harris887/AGV7/AGV7_DAM0808.jpg

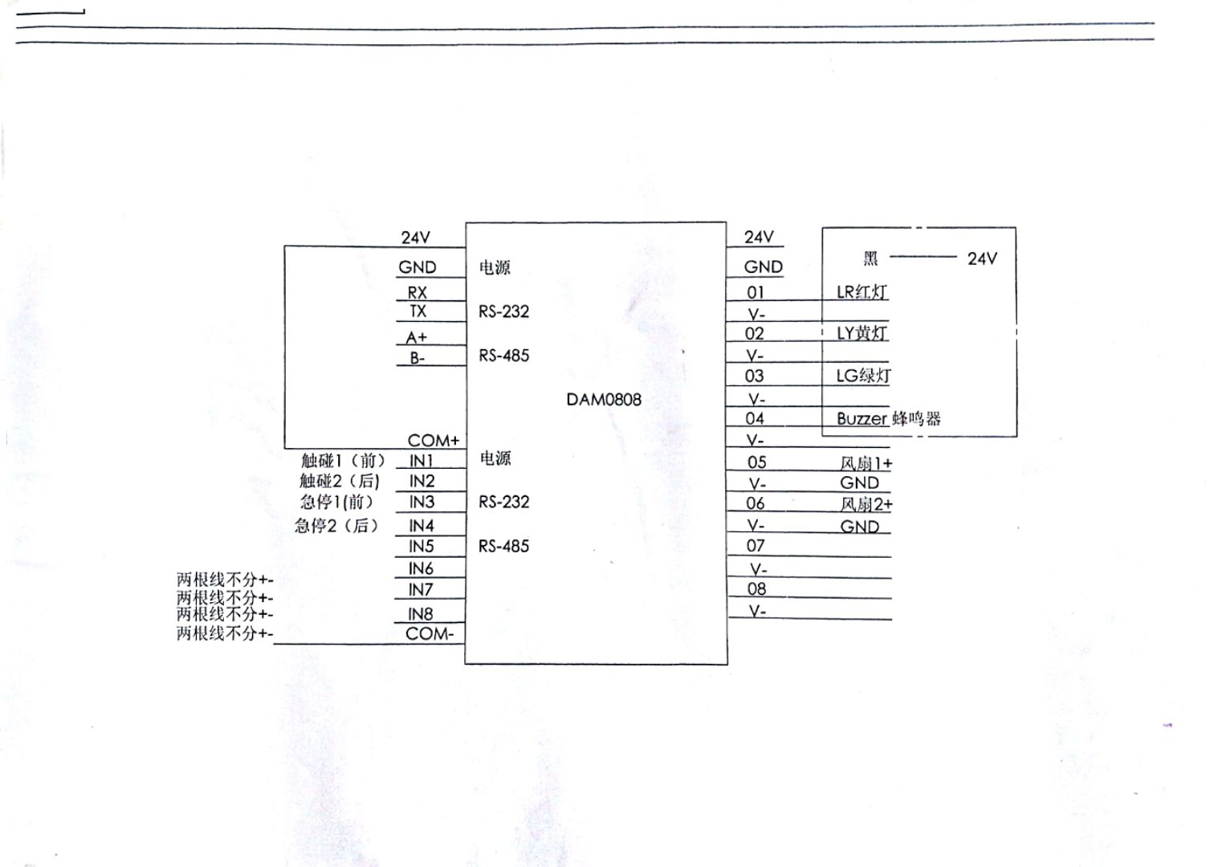
AGV7_DAM0808.jpg
