harris887/AGV7/警报音列表.jpg

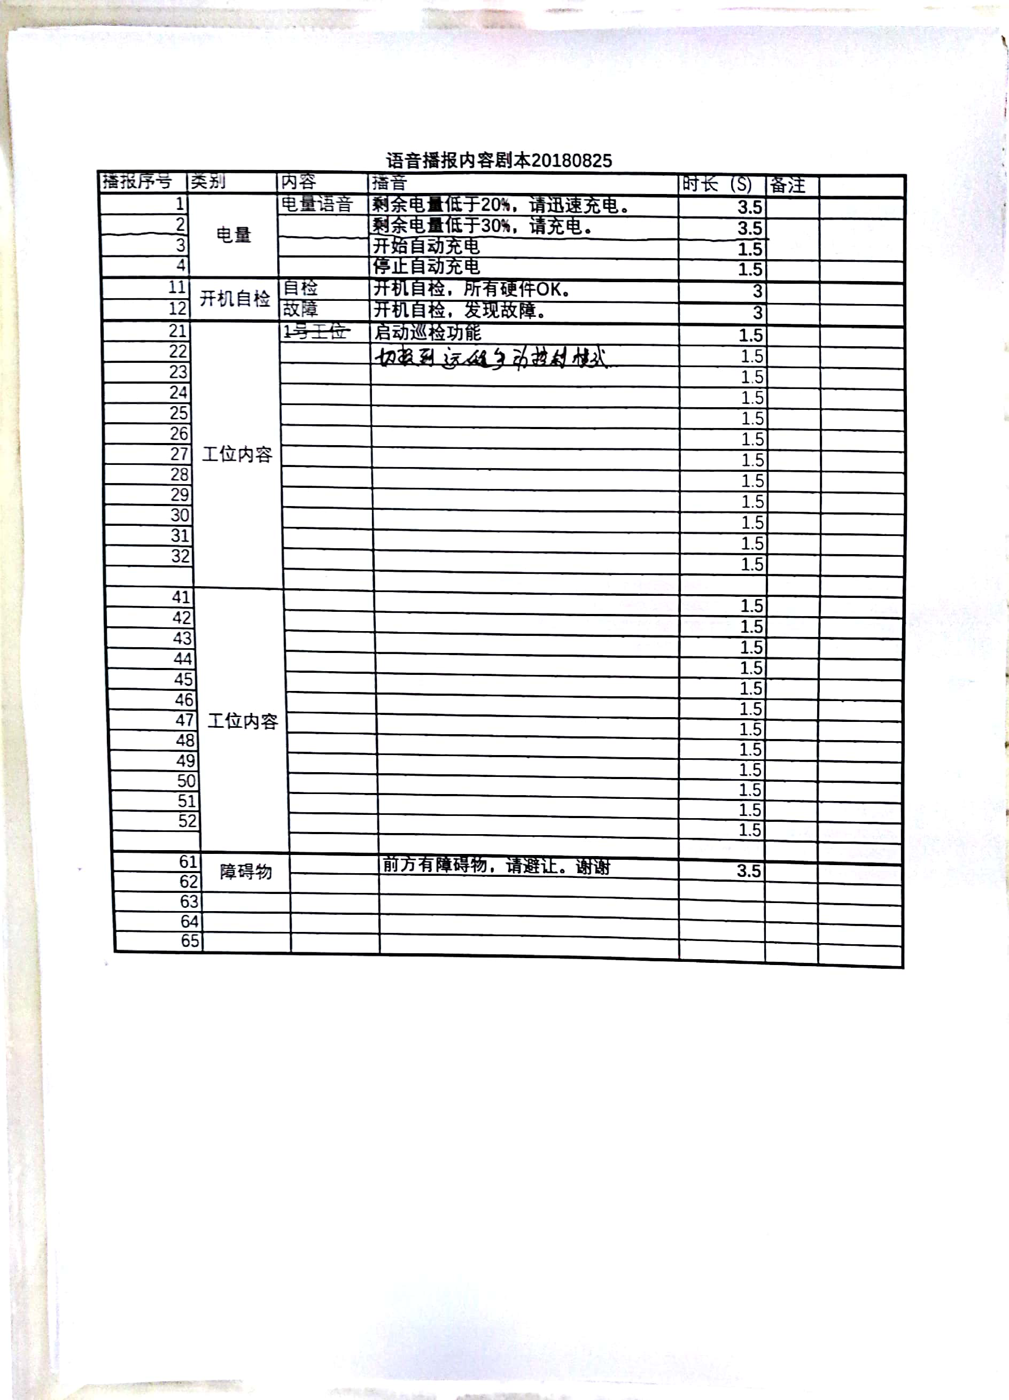
警报音列表.jpg
