harris887/AGV7/User/LedDisp.c

#include "user_inc.h"

u8 key_status=0;

void LedDispInit( void )
{
  GPIO_InitTypeDef GPIO_InitStructure;
  
  GPIO_InitStructure.GPIO_Pin =  LED1_PIN | LED2_PIN | LED3_PIN ; 
  GPIO_InitStructure.GPIO_Mode = GPIO_Mode_Out_PP; //开漏输出，5V上拉电阻
  GPIO_InitStructure.GPIO_Speed = GPIO_Speed_50MHz;
  GPIO_Init(LED3_PORT, &GPIO_InitStructure); 
  
  GPIO_InitStructure.GPIO_Pin =  LED5_PIN | LED6_PIN ; 
  GPIO_InitStructure.GPIO_Mode = GPIO_Mode_Out_PP; //开漏输出，5V上拉电阻
  GPIO_InitStructure.GPIO_Speed = GPIO_Speed_50MHz;
  GPIO_Init(LED5_PORT, &GPIO_InitStructure);   
  
  ClrLED1();
  ClrLED2();
  ClrLED3();

  ClrLED5();
  ClrLED6();
}


void LED_DISPLAY_Reset(void)
{
  SET_DIDO_Relay(DO_LED_Red, 0);
  SET_DIDO_Relay(DO_LED_Yellow, 0);
  SET_DIDO_Relay(DO_LED_Green, 0);
}

void LED_WATER_Display(u16 SPEED)
{
  static u32 NumOfSysTickIntBk;
  static u16 water_led_timer=0;
  static u16 water_led_status=0;
  if(NumOfSysTickInt!=NumOfSysTickIntBk)
  {
    NumOfSysTickIntBk=NumOfSysTickInt;
    if(water_led_timer) water_led_timer--;
  }
  else return;
  //流水灯
  switch(water_led_status)
  {
  case 0:
    {
      water_led_status=1;
      water_led_timer=SPEED;
      
      SET_DIDO_Relay(DO_LED_Red, 0);
      SET_DIDO_Relay(DO_LED_Yellow, 0);
      SET_DIDO_Relay(DO_LED_Green, 0);
    }
    break;
  case 1:
    if(water_led_timer==0)
    {
      water_led_status++;
      water_led_timer=SPEED;
     
      SET_DIDO_Relay(DO_LED_Red, 1);
      SET_DIDO_Relay(DO_LED_Yellow, 0);
      SET_DIDO_Relay(DO_LED_Green, 0);      
    }
    break;   
  case 2:
    if(water_led_timer==0)
    {
      water_led_status++;
      water_led_timer=SPEED;
      SET_DIDO_Relay(DO_LED_Red, 0);
      SET_DIDO_Relay(DO_LED_Yellow, 1);
      SET_DIDO_Relay(DO_LED_Green, 0);  
    }
    break;
  case 3:
    if(water_led_timer==0)
    {
      water_led_status=1;
      water_led_timer=SPEED;
      SET_DIDO_Relay(DO_LED_Red, 0);
      SET_DIDO_Relay(DO_LED_Yellow, 0);
      SET_DIDO_Relay(DO_LED_Green, 1);      
    }
    break;    
  default: water_led_status=0;
  }
}


void LED_LOW_POWER_Display(u16 SPEED)
{
  static u32 NumOfSysTickIntBk;
  static u16 water_led_timer=0;
  static u16 water_led_status=0;
  if(NumOfSysTickInt!=NumOfSysTickIntBk)
  {
    NumOfSysTickIntBk=NumOfSysTickInt;
    if(water_led_timer)
    {
      water_led_timer--;
      return;
    }
  }
  else return;
  
  switch(water_led_status)
  {
  case 0:
    {
      water_led_status=1;
      water_led_timer=SPEED;
      SET_DIDO_Relay(DO_LED_Red, 1);
      SET_DIDO_Relay(DO_LED_Yellow, 1);
      SET_DIDO_Relay(DO_LED_Green, 1); 
    }
    break;
  case 1:
    {
      water_led_status=0;
      water_led_timer=SPEED;
      SET_DIDO_Relay(DO_LED_Red, 0);
      SET_DIDO_Relay(DO_LED_Yellow, 0);
      SET_DIDO_Relay(DO_LED_Green, 0); 
    }
    break;  
  default:
    water_led_status=0;
  }
}

/*急停状态，红灯闪烁*/
void LED_IM_STOP_Display(u16 SPEED)
{
  static u32 NumOfSysTickIntBk;
  static u16 water_led_timer=0;
  static u16 water_led_status=0;
  if(NumOfSysTickInt!=NumOfSysTickIntBk)
  {
    NumOfSysTickIntBk=NumOfSysTickInt;
    if(water_led_timer)
    {
      water_led_timer--;
      return;
    }
  }
  else return;
  
  switch(water_led_status)
  {
  case 0:
    {
      water_led_status=1;
      water_led_timer=SPEED;
      SET_DIDO_Relay(DO_LED_Red, 1);
    }
    break;
  case 1:
    {
      water_led_status=0;
      water_led_timer=SPEED;
      SET_DIDO_Relay(DO_LED_Red, 0);
    }
    break;  
  default:
    water_led_status=0;
  }
}

/*巡线状态，绿灯闪烁*/
void LED_FOLLOW_LINE_Display(u16 SPEED)
{
  static u32 NumOfSysTickIntBk;
  static u16 water_led_timer = 0;
  static u16 water_led_status = 0;
  if(NumOfSysTickInt != NumOfSysTickIntBk)
  {
    NumOfSysTickIntBk = NumOfSysTickInt;
    if(water_led_timer)
    {
      water_led_timer--;
      return;
    }
  }
  else return;
  
  switch(water_led_status)
  {
  case 0:
    {
      water_led_status = 1;
      water_led_timer = SPEED;
      SET_DIDO_Relay(DO_LED_Green, 1);
    }
    break;
  case 1:
    {
      water_led_status = 0;
      water_led_timer = SPEED;
      SET_DIDO_Relay(DO_LED_Green, 0);
    }
    break;  
  default:
    water_led_status = 0;
  }
}

/*急停状态，黄灯闪烁*/
void LED_BARRIER_Display(u16 SPEED)
{
  static u32 NumOfSysTickIntBk;
  static u16 water_led_timer=0;
  static u16 water_led_status=0;
  if(NumOfSysTickInt!=NumOfSysTickIntBk)
  {
    NumOfSysTickIntBk=NumOfSysTickInt;
    if(water_led_timer)
    {
      water_led_timer--;
      return;
    }
  }
  else return;
  
  switch(water_led_status)
  {
  case 0:
    {
      water_led_status=1;
      water_led_timer=SPEED;
      SET_DIDO_Relay(DO_LED_Yellow, 1);
    }
    break;
  case 1:
    {
      water_led_status=0;
      water_led_timer=SPEED;
      SET_DIDO_Relay(DO_LED_Yellow, 0);
    }
    break;  
  default:
    water_led_status=0;
  }
}


/*RFID状态，蓝灯闪烁*/
void LED_RFID_Display(u16 SPEED)
{
  static u32 NumOfSysTickIntBk;
  static u16 water_led_timer=0;
  static u16 water_led_status=0;
  if(NumOfSysTickInt!=NumOfSysTickIntBk)
  {
    NumOfSysTickIntBk=NumOfSysTickInt;
    if(water_led_timer)
    {
      water_led_timer--;
      return;
    }
  }
  else return;
  
  switch(water_led_status)
  {
  case 0:
    {
      water_led_status=1;
      water_led_timer=SPEED;
      SET_DIDO_Relay(DO_LED_Yellow, 1);
      SET_DIDO_Relay(DO_LED_Green, 1); 
    }
    break;
  case 1:
    {
      water_led_status=0;
      water_led_timer=SPEED;
      SET_DIDO_Relay(DO_LED_Yellow, 0);
      SET_DIDO_Relay(DO_LED_Green, 0); 
    }
    break;  
  default:
    water_led_status=0;
  }
}

/*充电状态，三灯闪烁*/
void LED_CHARGE_Display(u16 SPEED)
{
  static u32 NumOfSysTickIntBk;
  static u16 water_led_timer = 0;
  static u16 water_led_status = 0;
  if(NumOfSysTickInt != NumOfSysTickIntBk)
  {
    NumOfSysTickIntBk = NumOfSysTickInt;
    if(water_led_timer)
    {
      water_led_timer--;
      return;
    }
  }
  else return;
  
  switch(water_led_status)
  {
  case 0:
    {
      water_led_status = 1;
      water_led_timer = SPEED;
      SET_DIDO_Relay(DO_LED_Red, 1);
      SET_DIDO_Relay(DO_LED_Yellow, 1);
      SET_DIDO_Relay(DO_LED_Green, 1); 
    }
    break;
  case 1:
    {
      water_led_status = 0;
      water_led_timer = SPEED;
      SET_DIDO_Relay(DO_LED_Red, 0);
      SET_DIDO_Relay(DO_LED_Yellow, 0);
      SET_DIDO_Relay(DO_LED_Green, 0); 
    }
    break;  
  default:
    water_led_status = 0;
  }
}
