harris887/AGV7/User/SpeedLine.c

#include "user_inc.h"


const SPEED_STEP_OPTION SPEED_STEP_OPTION_List[SPEED_STEP_NUM]=
{
        //高电平中断数	  低电平中断数	  100ms近似的脉冲数             //      厘米/秒

	{	834	,	833	,	1		},	//	0.599880024       -step_001
	{	417	,	416	,	2		},	//	1.200480192
	{	278	,	278	,	4		},	//	1.798561151
	{	209	,	208	,	5		},	//	2.398081535
	{	167	,	166	,	6		},	//	3.003003003
	{	139	,	139	,	7		},	//	3.597122302
	{	119	,	119	,	8		},	//	4.201680672
	{	104	,	104	,	10		},	//	4.807692308
	{	93	,	92	,	11		},	//	5.405405405
	{	84	,	83	,	12		},	//	5.988023952       -step_010
	{	76	,	76	,	13		},	//	6.578947368
	{	70	,	69	,	14		},	//	7.194244604
	{	64	,	64	,	16		},	//	7.8125
	{	60	,	59	,	17		},	//	8.403361345
	{	56	,	55	,	18		},	//	9.009009009
	{	52	,	52	,	19		},	//	9.615384615
	{	49	,	49	,	20		},	//	10.20408163
	{	47	,	46	,	22		},	//	10.75268817
	{	44	,	44	,	23		},	//	11.36363636
	{	42	,	41	,	24		},	//	12.04819277       -step_020
	{	40	,	39	,	25		},	//	12.65822785
	{	38	,	38	,	26		},	//	13.15789474
	{	36	,	36	,	28		},	//	13.88888889
	{	35	,	34	,	29		},	//	14.49275362
	{	34	,	33	,	30		},	//	14.92537313
	{	32	,	32	,	31		},	//	15.625
	{	31	,	31	,	32		},	//	16.12903226
	{	30	,	30	,	33		},	//	16.66666667
	{	29	,	28	,	35		},	//	17.54385965
	{	28	,	28	,	36		},	//	17.85714286       -step_030
	{	27	,	27	,	37		},	//	18.51851852
	{	26	,	26	,	38		},	//	19.23076923
	{	26	,	25	,	39		},	//	19.60784314
	{	25	,	24	,	41		},	//	20.40816327
	{	24	,	24	,	42		},	//	20.83333333
	{	23	,	23	,	43		},	//	21.73913043
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
	{	9	,	8	,	118		},	//	58.82352941     -step_100

};


SPEED_STEP_OPTION* GetSpeedStepOption(u16 speed_1_100)
{
  if(speed_1_100<1) speed_1_100=1;
  else if(speed_1_100>SPEED_STEP_NUM) speed_1_100=SPEED_STEP_NUM;
  return (SPEED_STEP_OPTION*)&(SPEED_STEP_OPTION_List[speed_1_100-1]);
}
