harris887/AGV7/User/Charge.h

#ifndef _charge_h_
#define _charge_h_

#include "user_inc.h"

#define DEFAULT_MIN_CHARGE_CYCLE_IN_S  60
#define CHARGE_ON                      1
#define CHARGE_OFF                     0
#define MIN_CHARGE_CURRENT_IN_0D01A    200
#define CHARGE_COMM_MIN_COUNTER        -30
#define CHARGE_P100_THRESHOLD          20
typedef struct
{
  u16 Voltage; // 电压 (单位：0.01V)
  u16 Current; // 电流 (单位：0.01A)
  u16 Cap;     // 容量
  u16 Time;    // 时间 (单位：min)
  u16 Refresh;
  u32 RxNum;
}CHARGE_STATUS;

extern MODBUS_SAMPLE MODBUS_Charge;
extern u32 CHARGE_COMM_Timout;
extern CHARGE_STATUS CHARGE_St;
extern u8 CHARGE_FULL_Flag;
extern s32 CHARGE_COMM_Counter;
extern u8 CHARGE_P100_Flag;

void Analysis_Receive_From_Charge(u8 data,MODBUS_SAMPLE* pMODBUS);
void SET_Charge(u8 on_off);
void CHARGE_Task(void);







#endif
