harris887/AGV7/User/user_inc.h

#ifndef user_inc_h
#define user_inc_h

#include "stm32f10x_type.h"
#include "stm32f10x_lib.h"
#include "Usart.h"
#include "Delay.h"
#include "init.h"
#include "Adc.h"
#include "LedDisp.h"
 
#include "moto.h"

#include "Protocol.h"
#include "user_lib.h"
#include "ModBus.h"
#include "Program.h"
#include "SpeedLine.h"
#include "Pid.h"
#include "Remote.h"
#include "Buzzer.h"
#include "Button.h"
#include "ModBus_UserInterface.h"
#include "RTC_Time.h"
#include "Rfid.h"
//#include "UltraSonic.h"
#include "WK2124.h"
#include "voice_warner.h"
#include "can.h"
#include "moto_monitor.h"
#include "DIDO.h"
#include "Charge.h"
#include "Mining.h"
#include "BMS.h"

#define MODBUS_PARA_REFLUSH_FLASH_ENABLE  1//调试阶段不擦FLASH








  


#endif
