harris887/AGV7/User/Buzzer.c

#include "user_inc.h"

//BeepTimes-连续响的次数
//BeepOnMs-一次鸣叫的时间，单位ms
//BeepDealy-两次次鸣叫的间隔时间，单位ms
u16 Beep_Times=0;
u16 Beep_OnMs=0;
u16 Beep_Dealy=0;
u8 Beep_Pro=0;
u16 Relay_status=0;

void BUZZER_Init(void)
{
  GPIO_InitTypeDef GPIO_InitStructure;
  
  GPIO_InitStructure.GPIO_Pin =  BUZZER_A_PIN ; 
  GPIO_InitStructure.GPIO_Mode = GPIO_Mode_Out_PP; 
  GPIO_InitStructure.GPIO_Speed = GPIO_Speed_50MHz;
  GPIO_Init(BUZZER_A_PORT, &GPIO_InitStructure);  
  
  SetBuzzer(BUZZER_OFF);
}

void RELAY_Init(void)
{
  GPIO_InitTypeDef GPIO_InitStructure;
  
  GPIO_InitStructure.GPIO_Pin =  RELAY_1_PIN|RELAY_2_PIN|RELAY_3_PIN ; 
  GPIO_InitStructure.GPIO_Mode = GPIO_Mode_Out_PP; 
  GPIO_InitStructure.GPIO_Speed = GPIO_Speed_50MHz;
  GPIO_Init(RELAY_PORT, &GPIO_InitStructure); 
  
        if(Relay_status&2)
        {
          SetRelay(0,RELAY_ON);
        }
        else
        {
          SetRelay(0,RELAY_OFF);
        }
        
        if(Relay_status&1)
        {
          SetRelay(1,RELAY_ON);
        }
        else
        {
          SetRelay(1,RELAY_OFF); 
        }
        if(Relay_status&4)
        {
          SetRelay(2,RELAY_ON);
        }
        else
        {
          SetRelay(2,RELAY_OFF); 
        }        
}

void SetRelay(u8 num_0_1,u8 on_off)
{
    if(on_off)
    {
      if(num_0_1==0)
        RELAY_PORT->BSRR = RELAY_1_PIN;
      else if(num_0_1==1)
        RELAY_PORT->BSRR = RELAY_2_PIN;
      else
        RELAY_PORT->BSRR = RELAY_3_PIN;
    }
    else
    {
      if(num_0_1==0)
        RELAY_PORT->BRR = RELAY_1_PIN;
      else if(num_0_1==1)
        RELAY_PORT->BRR = RELAY_2_PIN;
      else
        RELAY_PORT->BRR = RELAY_3_PIN;
    }
    
}


void SetBuzzer(u8 on_off)
{
    if(on_off)
    {
      BUZZER_A_PORT->BSRR = BUZZER_A_PIN;
      //SET_DIDO_Relay(DO_Buzzer, 1);
    }
    else
    {
      BUZZER_A_PORT->BRR = BUZZER_A_PIN;  
      //SET_DIDO_Relay(DO_Buzzer, 0);
    }
}


void SetBeep(u16 BeepTimes,u16 BeepOnMs,u16 BeepDealy)
{
  Beep_Times=(BeepTimes)?BeepTimes:1;//最少鸣叫一次
  Beep_OnMs=(BeepOnMs>50)?BeepOnMs:50;//最少鸣叫50ms
  Beep_Dealy=(BeepDealy>50)?BeepDealy:50;//最少间隔50ms
  Beep_Pro=0;
}

void SetBeepForever(u16 BeepOnMs,u16 BeepDealy)
{
  if(Beep_Pro==0)
  {
    SetBeep(1,BeepOnMs,BeepDealy);
  }
}

void BEEP_TASK(void)
{
  static u32 NumOfSysTickIntBk;
  static u16 Counter;
  if(NumOfSysTickIntBk!=NumOfSysTickInt)
  {
    NumOfSysTickIntBk=NumOfSysTickInt;
  }
  else return;  
  
  if(Beep_Times==0) return;
  
  switch(Beep_Pro)
  {
  case 0:
    SetBuzzer(BUZZER_ON);
    Counter=0;
    Beep_Pro++;
    break;
  case 1:
    Counter++;
    if(Counter>=Beep_OnMs)
    {
      SetBuzzer(BUZZER_OFF);
      Counter=0;
      Beep_Pro++;
    }
    break;
  case 2:
    Counter++;
    if(Counter>=Beep_Dealy)
    {
      if(Beep_Times) Beep_Times-=1;
      Counter=0;
      Beep_Pro=0;
    }    
    break;
  default:
    {
      Beep_Pro=0;
      Beep_Times=0;
    }
  }
}
