harris887/AGV7/(commit log)

2018-08-02 add device driver
2018-08-05 TEST laser and moto read bad
2018-08-07 fix uart5 RE DE bug [jtag rmap]
    [Main.c, Usart.c, Usart.h, init.c, moto.c]
2018-08-09 modify HALL SENSOR driver
2018-08-11 add RFID DIDO CHARGE driver
2018-08-28 modify hall get and test ok
2018-08-31 add BMS and not finish
2018-08-31 update BMS and CHARGE
2018-09-02 update charge, bms
2018-09-05 fix Touch and barrier_placeid bugs
    [DIDO.c, Program.c]
2018-09-10 add program flow doc and not finish
2018-09-10 update flow doc
2018-09-12 modify brake with follow line and not test
2018-09-15 add debug_infor for hall and add build time
2018-09-20 charge 100 then stop
2018-09-27 modify charge form 50% and pid_p from 5.0 to 4.0
2018-09-29 modify LASER_DEEP_WIDTH_TO_PARAM
2018-09-29 fix charge_full bug and force charge less time
    [Charge.c, Charge.h, Main.c, ModBus_UserInterface.c, ModBus_UserInterface.h, Program.h]
2019-01-13 fix charge problem
